vanson2209/final_project/Circuit/Receive_station_pdf.pdf

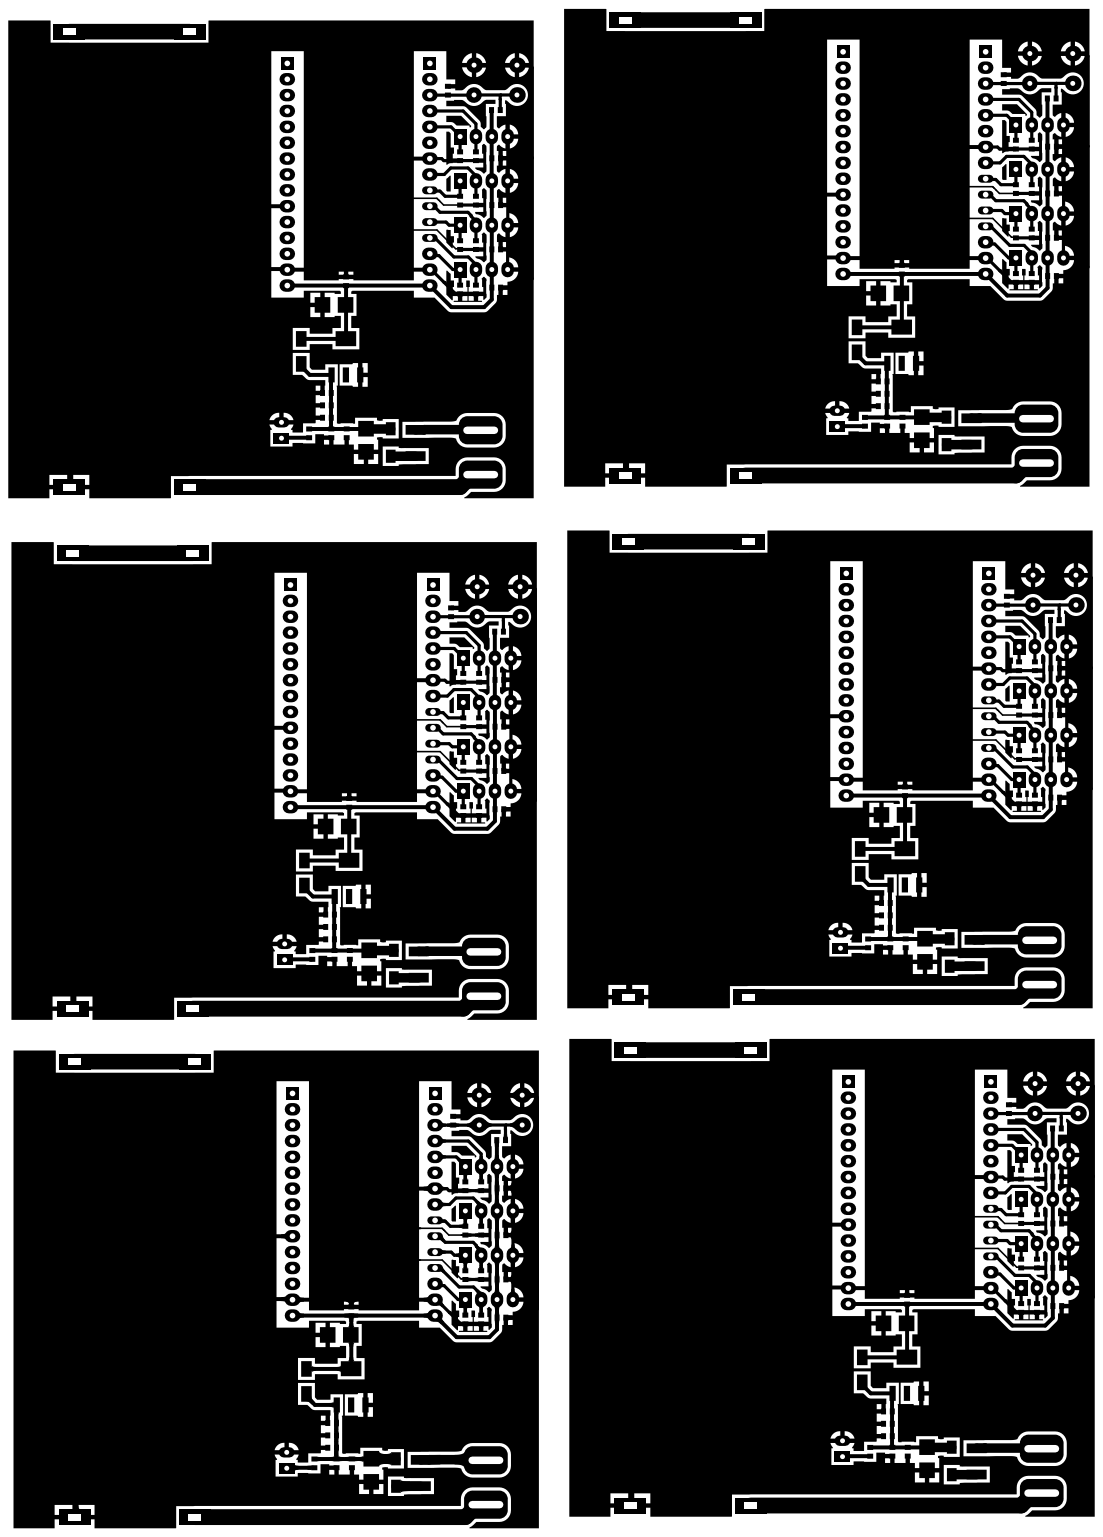
[picture p213: page 1]
