vanson2209/final_project/Circuit/PIN_3/PIN_3.pdf

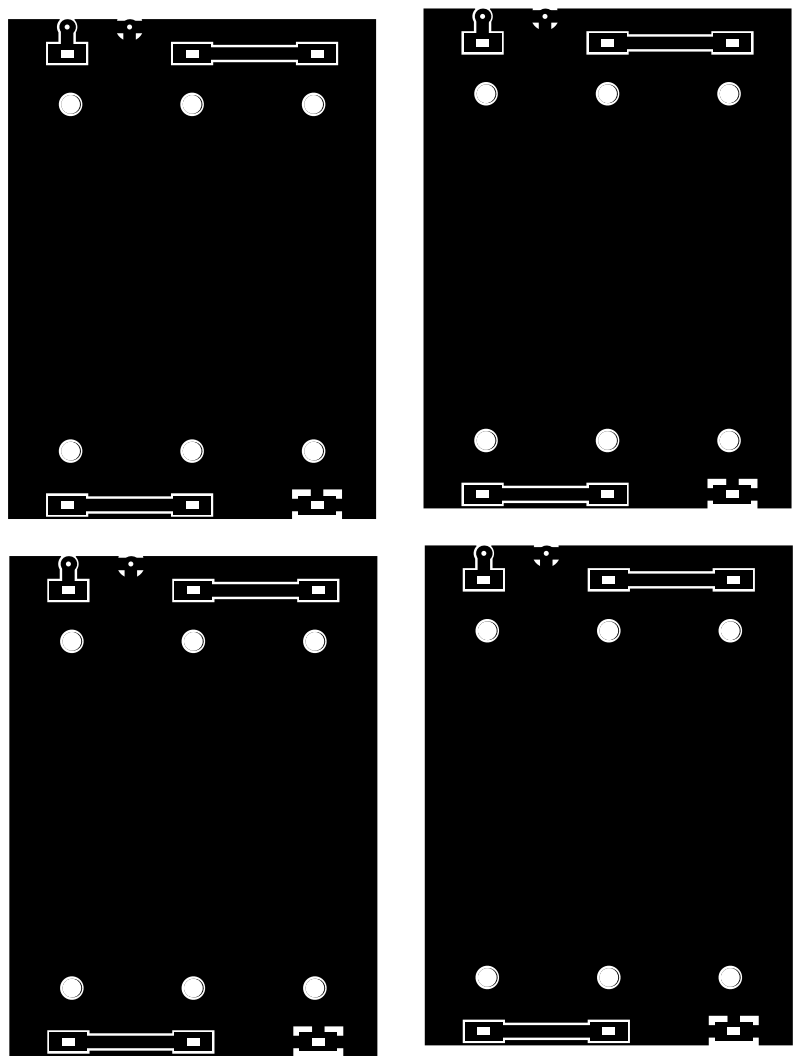
[picture p214: page 1]
