vanson2209/final_project/Circuit/Remote/Remote_BOTTOM.pdf

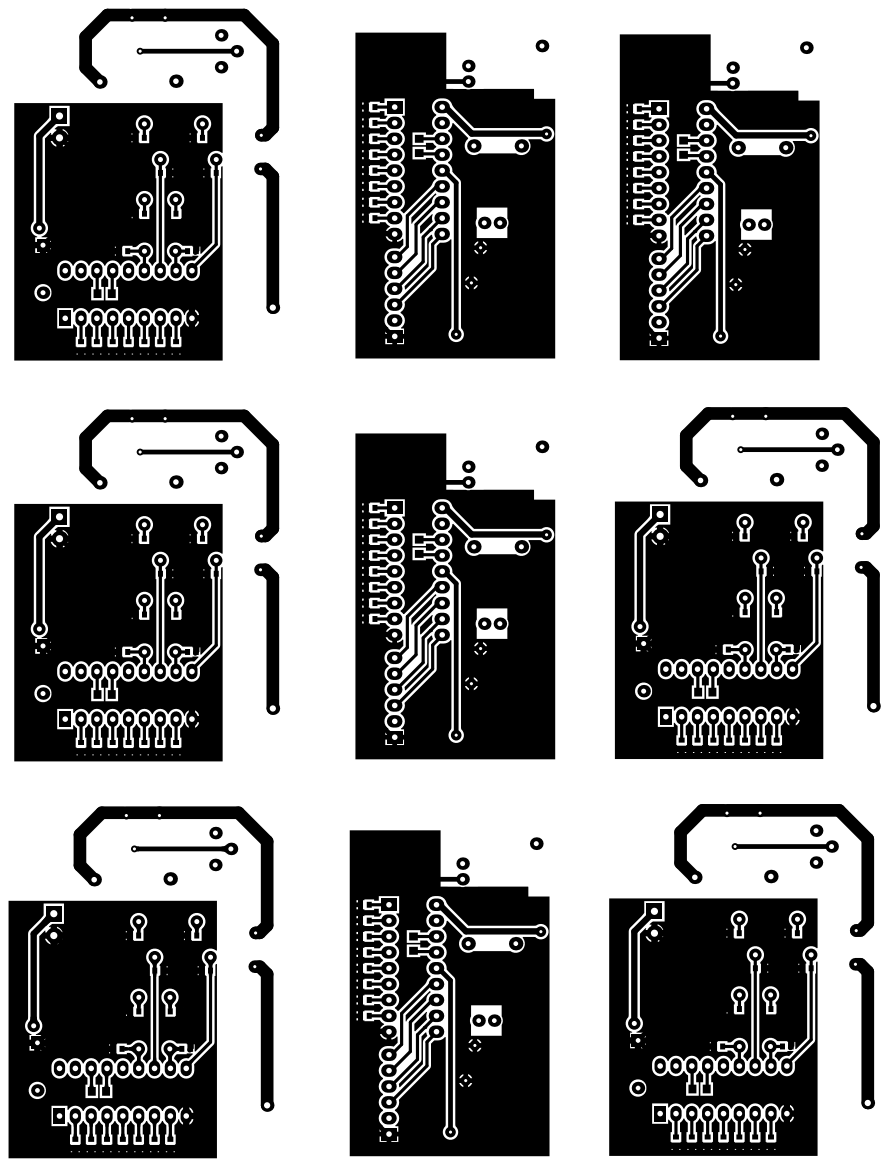
[picture p215: page 1]
