vanson2209/final_project/Circuit/Remote/Remote_TOP.pdf

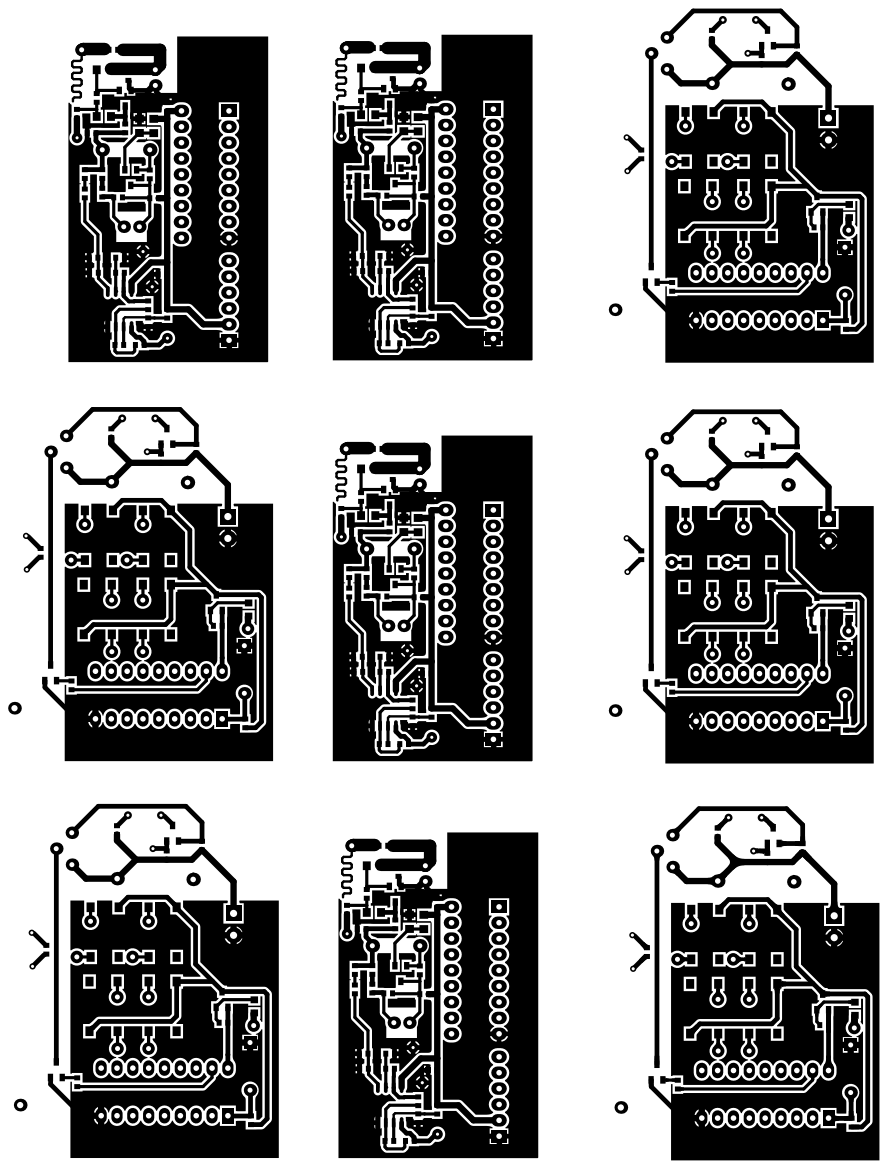
[picture p216: page 1]
