vanson2209/final_project/Circuit/Remote/Remote_V3.pdf

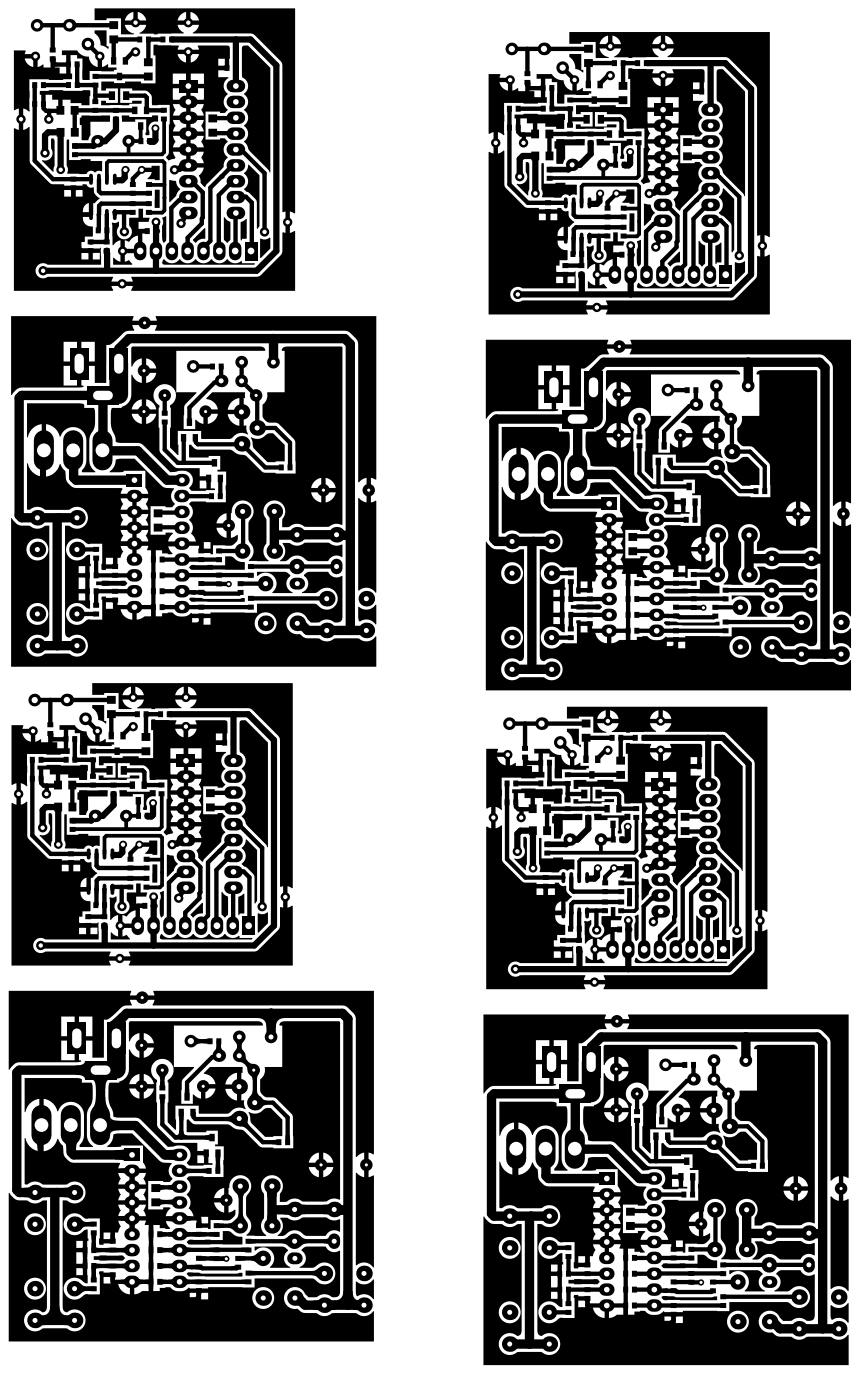
[picture p217: page 1]
