vanson2209/final_project/Circuit/Remote/Transfer/Transfer_V3.pdf

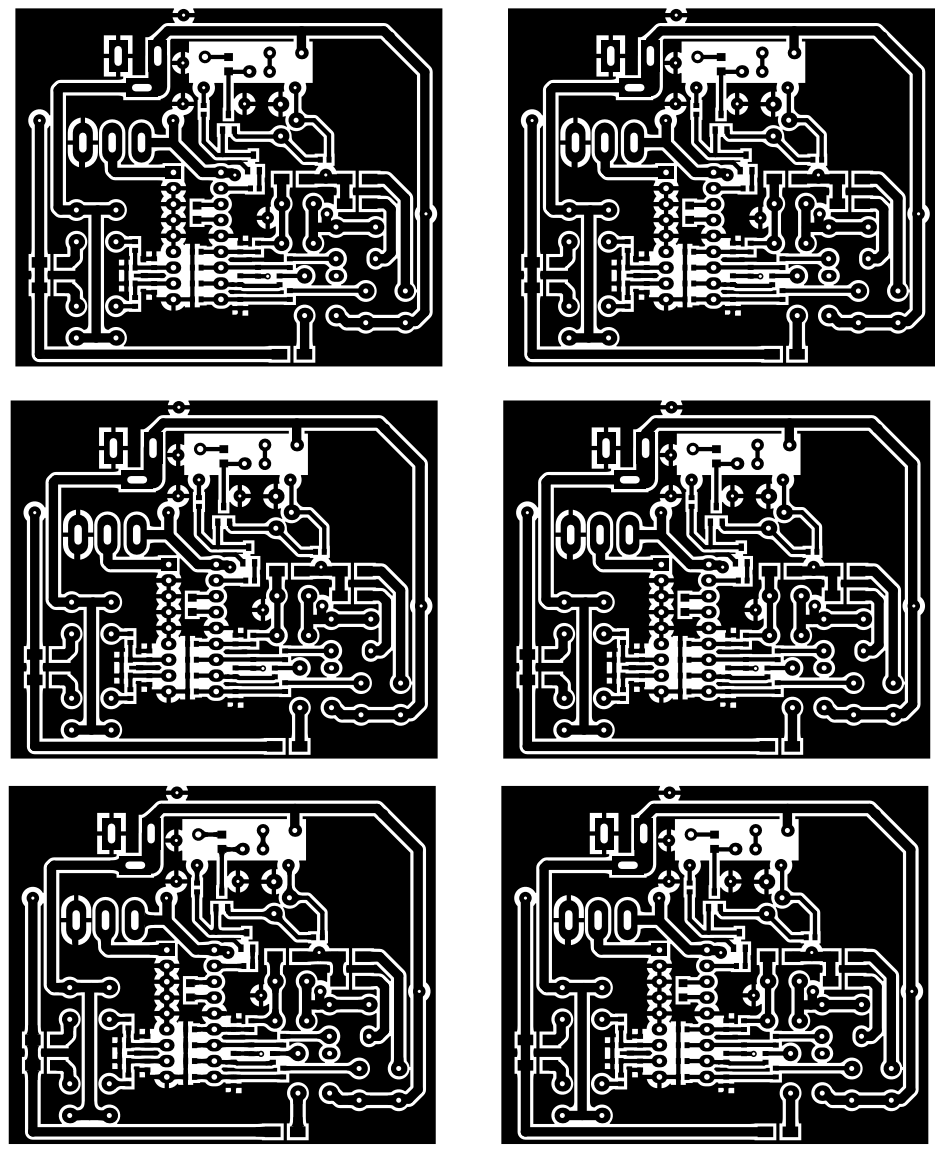
[picture p218: page 1]
