vanson2209/final_project/Circuit/Remote/Remote_V2.pdf

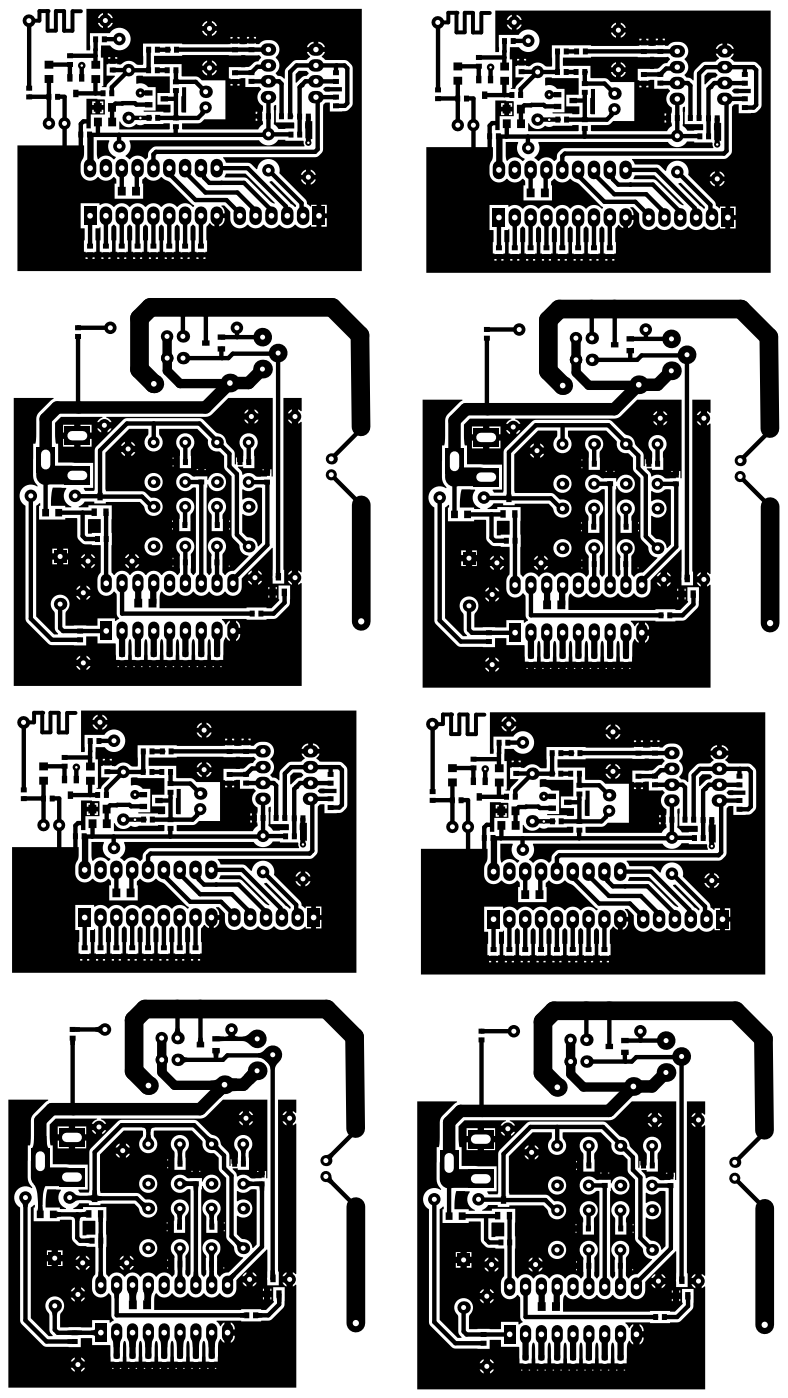
[picture p219: page 1]
