vanson2209/final_project/(list of files, drawings)

Other design files:
Circuit/Hall_Sensor_SMD/IO_AGV.PrjPcb
Circuit/Hall_Sensor_SMD/IO_Hall_Sensor_SMD_Pcb.PcbDoc
Circuit/Hall_Sensor_SMD/IO_Hall_Sensor_SMD_Sch.SchDoc
Circuit/Main_V1/Control.SchDoc
Circuit/Main_V1/Main_V1.PrjPcb
Circuit/Main_V1/Peripheral.SchDoc
Circuit/Main_V1/Power.SchDoc
Circuit/PIN_3/PIN_3.PrjPcb
Circuit/PIN_3/PIN_3_Pcb.PcbDoc
Circuit/PIN_3/PIN_3_Sch.SchDoc
Circuit/PIN_12V/PIN_12V.PrjPcb
Circuit/PIN_12V/PIN_12V_Pcb.PcbDoc
Circuit/PIN_12V/PIN_12V_Sch.SchDoc
Circuit/Receive_Station/Receive_Station.PrjPcb
Circuit/Receive_Station/Receive_Station_PCB.PcbDoc
Circuit/Receive_Station/Receive_Station_Sch.SchDoc
Circuit/Remote/Receive/Receive_V1.PrjPcb
Circuit/Remote/Receive/Receive_V1_Pcb.PcbDoc
Circuit/Remote/Receive/Receive_V1_Sch.SchDoc
Circuit/Remote/Receive_V1.PrjPcb
Circuit/Remote/Receive_V1_Pcb.PcbDoc
Circuit/Remote/Receive_V1_Sch.SchDoc
Circuit/Remote/Transfer/Transfer/Transfer.PrjPcb
Circuit/Remote/Transfer/Transfer/Transfer_V1_Sch.SchDoc
Circuit/Remote_Circuit/Remote_Circuit.PrjPcb
Circuit/Remote_Circuit/Remote_Circuit_Pcb.PcbDoc
Circuit/Remote_Circuit/Remote_Circuit_Sch.SchDoc
Circuit/signal_circuit/PCB1.PcbDoc
Circuit/signal_circuit/signal_circuit.PrjPcb
Circuit/signal_circuit/signal_circuit_PCB.PcbDoc
Circuit/signal_circuit/signal_circuit_Sch.SchDoc
Circuit/signal_transfer/signal_transfer.PrjPcb
Circuit/signal_transfer/signal_transfer_Pcb.PcbDoc
Circuit/signal_transfer/signal_transfer_Sch.SchDoc
Circuit/Slave_Board/Slave_Board.PrjPcb
Circuit/Slave_Board/Slave_Board_Sch.SchDoc
Simulate/Remote.ms14
