vanson2209/final_project/Code/AGV/Core/Src/main.c

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
/* Includes ------------------------------------------------------------------*/
#include "main.h"

/* USER CODE BEGIN Includes */
#include "math.h"
#include "lcd.h"
/* USER CODE END Includes */

/* USER CODE BEGIN PTD */
typedef enum {AUTO = 0, NONE_AUTO_REMOTE, NONE_AUTO_WEB, STOP} state_t;
typedef enum {MOVE = 0, PROCESS} state_moving_t;
typedef enum {PASS_START = 0, LEFT_START} state_start_t;
typedef enum {START = 0, PICK_UP, SHIP, COME_BACK, COME_HOME} state_process_t;
typedef enum {PRE_UP = 0, WAIT_UP, OPERATE, WAIT_DONE_PICK, DONE_PICK} state_pick_t;
typedef enum {PROCESS_SHIP = 0, GO_SHIP, PUT_DOWN, DONE_SHIP} state_ship_t;
typedef enum {PROCESS_GO = 0, WAIT_CROSS} state_go_t;
typedef enum {PRE_DOWN = 0, WAIT_ROBOT, PROCESS_PUT_DOWN, DONE_PUT_DOWN} state_put_down_t;
typedef enum {PRE_CB = 0, GO_CB, DONE_CB} state_comeback_t;
typedef enum {PRE_CH = 0, GO_HOME, LEFT_CH, WAIT_DONE_CH, DONE_CH} state_come_home_t;
typedef enum {PRE_STOP = 0, CHECK_OUT, WAIT_OUT} state_stop_t;

typedef enum {CHECK_SIGN_LEFT = 0, PASS_LEFT_1, TURN_LEFT, PASS_LEFT_2} state_turn_left_intersection_t;
typedef enum {CHECK_SIGN_RIGHT = 0, TURN_RIGHT} state_turn_right_intersection_t;
typedef enum {CHECK_SIGN_CROSS = 0, PASS_CROSS_1, PASS_CROSS_2} state_cross_intersection_t;
typedef enum {CHECK_SIGN_BACK = 0, PASS_BACK_1, TURN_LEFT_1, TURN_LEFT_2, PASS_BACK_2} state_back_intersection_t;

typedef enum {PS1 = 0, TS1, RS1, RS2, PS2, TS2, RS3, RS4} list_station_t;
typedef enum {UP = 0, DOWN, LEFT, RIGHT, PAUSE} direct_t;

typedef enum {reset = 0, set} bool_t;

typedef struct{
	uint8_t goods_position[4];
	uint8_t goods_quantity;
	uint8_t goods_tmp;
	list_station_t goods_list[4];
	bool_t goods_side[4];
	bool_t goods_station[2];
} goods_infor_t;

typedef struct{
	uint8_t agv_position;
	uint8_t agv_side;
	direct_t agv_direct;
	direct_t agv_next_step_go;
	volatile bool_t agv_power;
} AGV_infor_t;

/* USER CODE END PTD */

/* USER CODE BEGIN PD */
#define line_sensor 	35
#define i_axis				5
#define j_axis				5
#define GPIO_SET_PIN(GPIOx, GPIO_Pin_x) (GPIOx -> ODR |= GPIO_Pin_x)
#define GPIO_RESET_PIN(GPIOx, GPIO_Pin_x) (GPIOx -> ODR &= ~GPIO_Pin_x)

/* USER CODE END PD */

ADC_HandleTypeDef hadc1;
DMA_HandleTypeDef hdma_adc1;

I2C_HandleTypeDef hi2c2;

TIM_HandleTypeDef htim2;

UART_HandleTypeDef huart1;

/* USER CODE BEGIN PV */
uint16_t distance_tmp;
volatile uint32_t systick_count;
volatile state_t state;
state_moving_t state_moving;
state_stop_t state_stop;
state_process_t process_state;
state_pick_t pick_state;
state_ship_t ship_state;
state_go_t state_go;
state_put_down_t state_put_down;
state_start_t start;
state_comeback_t state_comeback;
volatile state_come_home_t state_come_home;

state_cross_intersection_t cross_interection_state = CHECK_SIGN_CROSS;
state_turn_left_intersection_t turn_left_interection_state = CHECK_SIGN_LEFT;
state_turn_right_intersection_t turn_right_interection_state = CHECK_SIGN_RIGHT;
state_back_intersection_t state_back_intersection = CHECK_SIGN_BACK;

volatile bool_t robot;

goods_infor_t goods_infor;
AGV_infor_t	agv_infor;

uint8_t Rx;
uint8_t Tx;
direct_t direct;

uint16_t data[5], data_max[5], data_min[5]; // gia tri mau tu
uint16_t sensor[5]; // gia tri doc mau tu
uint8_t check[5];	// gia tri kiem tra mau tu


uint8_t tmp_check;

/* USER CODE END PV */

void SystemClock_Config(void);
static void MX_GPIO_Init(void);
static void MX_DMA_Init(void);
static void MX_ADC1_Init(void);
static void MX_TIM2_Init(void);
static void MX_I2C2_Init(void);
static void MX_USART1_UART_Init(void);
/* USER CODE BEGIN PFP */

void V_Go_Straight(void);
void V_Go_Back(void);
void V_Turn_Left(void);
void V_Turn_Right(void);
void V_Control_Remote(void);
void V_Control_Web(void);

uint8_t V_Check_Sensor_Init(void);
void V_Sensor_Init(void);
uint8_t V_Check_Sensor(void);

void V_Start(void);
void V_Pick_Up(void);
void V_Ship(void);
void V_Come_Back(void);
void V_Come_Home(void);



void V_Put_Down(void);
 
void V_Analysis_Goods_List(bool_t v_goods_side[4], uint8_t v_goods_position[4], list_station_t v_goods_list[4]);

void V_Cross_the_Intersection(void);
void V_Turn_Left_at_the_Intersection(void);
void V_Turn_Right_at_the_Intersection(void);
void V_Turn_Back_at_the_Intersection(void);

void V_Determine_Next_Step(void);
uint16_t V_Determine_Distance(uint8_t xo, uint8_t yo, uint8_t x1, uint8_t y1, direct_t v_direct);
void V_Remove_Duplicate(list_station_t v_goods_list[4],  uint8_t* goods_quantity);
void V_Remove_First_Goods(list_station_t v_goods_list[4],  uint8_t goods_quantity);
void V_GO(void);

/* USER CODE END PFP */

/**
  * @brief  The application entry point.
  * @retval int
  */
int main(void)
{
  /* MCU Configuration--------------------------------------------------------*/

  /* Reset of all peripherals, Initializes the Flash interface and the Systick. */
  HAL_Init();

  /* Configure the system clock */
  SystemClock_Config();

  /* Initialize all configured peripherals */
  MX_GPIO_Init();
  MX_DMA_Init();
  MX_ADC1_Init();
  MX_TIM2_Init();
  MX_I2C2_Init();
  MX_USART1_UART_Init();
  /* USER CODE BEGIN 2 */
	state = AUTO;
	state_moving = MOVE;
	state_stop = PRE_STOP;
	process_state = START;
	pick_state = PRE_UP;
	ship_state = PROCESS_SHIP;
	state_go = PROCESS_GO;
	state_put_down = PRE_DOWN;
	start = PASS_START;
	robot = set;
	agv_infor.agv_power = reset;
	state_comeback = PRE_CB;
	state_come_home = PRE_CH;
	goods_infor.goods_station[0] = set;
	goods_infor.goods_station[1] = set;

	cross_interection_state = CHECK_SIGN_CROSS;
	turn_left_interection_state = CHECK_SIGN_LEFT;
	turn_right_interection_state = CHECK_SIGN_RIGHT;
	V_Go_Straight();
	HAL_TIM_PWM_Start(&htim2, TIM_CHANNEL_1);
	HAL_TIM_PWM_Start(&htim2, TIM_CHANNEL_2);
	Lcd_Init();
	
	HAL_UART_Receive_IT(&huart1, &Rx, 1);
	Tx = '0';
	HAL_UART_Transmit(&huart1, &Tx, 1, 100);
	while(agv_infor.agv_power != set){}
	Tx = '1';
	HAL_UART_Transmit(&huart1, &Tx, 1, 100);
	do
	{
		Lcd_Send_String_XY(1, 4, "Sampling!");
		Lcd_Goto_XY(2,1);
		Lcd_Send_String("Wait, Please!");
		V_Sensor_Init();
	}
	while(V_Check_Sensor_Init());
	htim2.Instance -> CCR1 = 8771;
	htim2.Instance -> CCR2 = 8888;
	Tx = '2';
	HAL_UART_Transmit(&huart1, &Tx, 1, 100);
	Lcd_Send_String_XY(1, 3, "GOING TO TS1");
	HAL_Delay(500);
  /* USER CODE END 2 */

  /* Infinite loop */
  /* USER CODE BEGIN WHILE */
  while (1)
  {
    /* USER CODE END WHILE */

    /* USER CODE BEGIN 3 */
		switch(state)
		{
			case AUTO:
			{	
				switch(state_moving)
				{
					case MOVE:
					{
						HAL_ADC_Start_DMA(&hadc1, (uint32_t *)data, 5);
						HAL_Delay(1);
						HAL_ADC_Stop_DMA(&hadc1);
						switch(V_Check_Sensor())
						{
							case 0:
								htim2.Instance -> CCR1 = 9868;	//AGV1			//AGV1: val1:val2 = 9868:9999
								htim2.Instance -> CCR2 = 9999;
								break;
							case 1:
								htim2.Instance -> CCR1 = 9868;	//AGV2
								htim2.Instance -> CCR2 = 8888;
								break;
							case 2:
								htim2.Instance -> CCR1 = 9868;	//AGV2
								htim2.Instance -> CCR2 = 5555;
								break;
							case 3:
								htim2.Instance -> CCR1 = 9868;	//AGV2
								htim2.Instance -> CCR2 = 3333;
								break;
							case 4:
								htim2.Instance -> CCR1 = 9868;	//AGV2
								htim2.Instance -> CCR2 = 1666;
								break;
							case 5:
								htim2.Instance -> CCR1 = 8771;	//AGV2
								htim2.Instance -> CCR2 = 9999;
								break;
							case 6:
								htim2.Instance -> CCR1 = 5482;	//AGV2
								htim2.Instance -> CCR2 = 9999;
								break;
							case 7:
								htim2.Instance -> CCR1 = 3289;	//AGV2
								htim2.Instance -> CCR2 = 9999;
								break;
							case 8:
								htim2.Instance -> CCR1 = 1644;	//AGV2
								htim2.Instance -> CCR2 = 9999;
								break;
							case 9:
								state_moving = PROCESS;
								break;
						}
						break;
					}
					case PROCESS:
					{
						switch (process_state)
						{
							case START:
								V_Start();
								break;
							case PICK_UP:
								V_Pick_Up();
								break;
							case SHIP:
								V_Ship();
									break;
							case COME_BACK:
								V_Come_Back();
								break;
							case COME_HOME:
								V_Come_Home();
						}
						break;
					}
				}
				break;
			}
			case NONE_AUTO_REMOTE:
				V_Control_Remote();
				break;
			case NONE_AUTO_WEB:
				V_Control_Web();
				break;
			case STOP:
			{
				switch(state_stop)
				{
					case PRE_STOP:
						htim2.Instance -> CCR1 = 0;
						htim2.Instance -> CCR2 = 0;
						systick_count = HAL_GetTick();
						state_stop = CHECK_OUT;
						break;
					case CHECK_OUT:
						if((GPIOB -> IDR  & GPIO_PIN_2) == GPIO_PIN_RESET)
						{
							if((HAL_GetTick() - systick_count) < 50)
							{
								state_stop = PRE_STOP;
								state = AUTO;
							}
							else
							{
								systick_count = HAL_GetTick();
								state_stop = WAIT_OUT;
							}
						}
						break;
					case 	WAIT_OUT:
						if((HAL_GetTick() - systick_count) > 1000)
						{
							state_stop = PRE_STOP;
							state = AUTO;
						}
						break;
				}
				break;
			}
		}
		
  }
  /* USER CODE END 3 */
}

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
/* USER CODE BEGIN 4 */

void HAL_GPIO_EXTI_Callback(uint16_t GPIO_Pin)
{
	switch (GPIO_Pin)
	{
		case GPIO_PIN_7:
			if(state == AUTO)
			{
				state = NONE_AUTO_REMOTE;
				htim2.Instance -> CCR1 = 0;
				htim2.Instance -> CCR2 = 0;
			}
			else
				state = AUTO;
			break;
		case GPIO_PIN_2:
				state = STOP;
			break;
	}
}
void HAL_UART_RxCpltCallback(UART_HandleTypeDef *huart)
{	
	HAL_UART_Receive_IT(&huart1, &Rx, 1);
	switch (Rx)
	{
		case '0':
			agv_infor.agv_power = set;	//POWER_ON
			Tx = 'E';
			HAL_UART_Transmit(&huart1, &Tx, 1, 100);
			break;
		case '1':
			agv_infor.agv_power = reset;	//POWER_OFF
			Tx = 'F';
			HAL_UART_Transmit(&huart1, &Tx, 1, 100);
			break;
		case '2':		//off the automation
			htim2.Instance -> CCR1 = 0;
			htim2.Instance -> CCR2 = 0;
			state = NONE_AUTO_WEB;
			break;
		case '3':			//on the automation
			state = AUTO;
			break;
		case '4':
			robot = reset;
			break;
		case '5':
			goods_infor.goods_list[goods_infor.goods_quantity] = RS1;
			goods_infor.goods_quantity ++;
			break;
		case '6':
			goods_infor.goods_list[goods_infor.goods_quantity] = RS2;
			goods_infor.goods_quantity ++;
			break;
		case '7':
			goods_infor.goods_list[goods_infor.goods_quantity] = RS3;
			goods_infor.goods_quantity ++;
			break;
		case '8':
			goods_infor.goods_list[goods_infor.goods_quantity] = RS4;
			goods_infor.goods_quantity ++;
			break;
		case '9':
			direct = UP;
			break;
		case 'A':
			direct = DOWN;
			break;
		case 'B':
			direct = LEFT;
			break;
		case 'C':
			direct = RIGHT;
			break;
		case 'D':
			direct = PAUSE;
			break;
		case 'E':
			goods_infor.goods_station[0] = reset;
			if((process_state == PICK_UP) && (goods_infor.goods_quantity == 0))
				pick_state = PRE_UP;
			break;
		case 'F':
			goods_infor.goods_station[1] = reset;
			if((process_state == PICK_UP) && (goods_infor.goods_quantity == 0))
				pick_state = PRE_UP;
			break;
		case 'G':
			goods_infor.goods_station[0] = set;
			break;
		case 'H':
			goods_infor.goods_station[1] = set;
			break;
	}
}
void V_Go_Straight(void)
{
	GPIO_RESET_PIN(GPIOA, GPIO_PIN_10);	//STB`
	GPIO_SET_PIN(GPIOA, GPIO_PIN_11);   //AIN1
	GPIO_RESET_PIN(GPIOA, GPIO_PIN_12);	//AIN2
	GPIO_SET_PIN(GPIOB, GPIO_PIN_4);   //BIN2
	GPIO_RESET_PIN(GPIOB, GPIO_PIN_5);	//BIN1
	GPIO_SET_PIN(GPIOA, GPIO_PIN_10);	//STB`
}
void V_Go_Back(void)
{
	GPIO_RESET_PIN(GPIOA, GPIO_PIN_10);	//STB`
	GPIO_RESET_PIN(GPIOA, GPIO_PIN_11);   //AIN1
	GPIO_SET_PIN(GPIOA, GPIO_PIN_12);	//AIN2
	GPIO_RESET_PIN(GPIOB, GPIO_PIN_4);   //BIN2
	GPIO_SET_PIN(GPIOB, GPIO_PIN_5);	//BIN1
	GPIO_SET_PIN(GPIOA, GPIO_PIN_10);	//STB`
}
void V_Turn_Left(void)
{
	htim2.Instance -> CCR1 = 8771;
	htim2.Instance -> CCR2 = 8888;
	HAL_Delay(600);
	GPIO_RESET_PIN(GPIOA, GPIO_PIN_10);	//STB`
	GPIO_RESET_PIN(GPIOA, GPIO_PIN_11);   //AIN1
	GPIO_SET_PIN(GPIOA, GPIO_PIN_12);	//AIN2
	GPIO_SET_PIN(GPIOA, GPIO_PIN_10);	//STB
	HAL_Delay(500);
	systick_count = HAL_GetTick();
	do
	{
		HAL_ADC_Start_DMA(&hadc1, (uint32_t *)data, 5);
		HAL_Delay(1);
		HAL_ADC_Stop_DMA(&hadc1);
		tmp_check = V_Check_Sensor();
	//	if((tmp > 4) && (tmp < 8))
		if((tmp_check == 0) || (tmp_check == 1) || (tmp_check == 5))
				break;
	} while((HAL_GetTick() - systick_count) < 500);
	GPIO_RESET_PIN(GPIOA, GPIO_PIN_10);	//STB`
	GPIO_SET_PIN(GPIOA, GPIO_PIN_11);   //AIN1
	GPIO_RESET_PIN(GPIOA, GPIO_PIN_12);	//AIN2
	GPIO_SET_PIN(GPIOA, GPIO_PIN_10);	//STB`
}
void V_Turn_Right(void)
{
	htim2.Instance -> CCR1 = 8771;
	htim2.Instance -> CCR2 = 8888;
	HAL_Delay(600);
	GPIO_RESET_PIN(GPIOA, GPIO_PIN_10);	//STB`
	GPIO_RESET_PIN(GPIOB, GPIO_PIN_4);   //BIN2
	GPIO_SET_PIN(GPIOB, GPIO_PIN_5);	//BIN1
	GPIO_SET_PIN(GPIOA, GPIO_PIN_10);	//STB`
	HAL_Delay(500);
	systick_count = HAL_GetTick();
	do
	{
		HAL_ADC_Start_DMA(&hadc1, (uint32_t *)data, 5);
		HAL_Delay(1);
		HAL_ADC_Stop_DMA(&hadc1);
		tmp_check = V_Check_Sensor();
		if((tmp_check == 0) || (tmp_check == 1) || (tmp_check == 5))
				break;
	} while((HAL_GetTick() - systick_count) < 500);
	GPIO_RESET_PIN(GPIOA, GPIO_PIN_10);	//STB`
	GPIO_SET_PIN(GPIOB, GPIO_PIN_4);   //BIN1
	GPIO_RESET_PIN(GPIOB, GPIO_PIN_5);	//BIN2
	GPIO_SET_PIN(GPIOA, GPIO_PIN_10);	//STB
}
void V_Control_Remote(void)
{
	if((GPIOB->IDR & GPIO_PIN_1) != GPIO_PIN_RESET)		//UP
	{
		if((GPIOA->IDR & GPIO_PIN_12) != GPIO_PIN_RESET)
			V_Go_Straight();
		htim2.Instance -> CCR1 = 9900;
		htim2.Instance -> CCR2 = 9999;
	}
	else if((GPIOA->IDR & GPIO_PIN_5) != GPIO_PIN_RESET)	//DOWN
	{
		if((GPIOA->IDR & GPIO_PIN_11) != GPIO_PIN_RESET)
			V_Go_Back();
		htim2.Instance -> CCR1 = 9900;
		htim2.Instance -> CCR2 = 9999;
	}
	else if((GPIOB->IDR & GPIO_PIN_0) != GPIO_PIN_RESET)	//LEFT
	{
		htim2.Instance -> CCR1 = 2192;
		htim2.Instance -> CCR2 = 9999;
	}
	else if((GPIOA->IDR & GPIO_PIN_6) != GPIO_PIN_RESET)		//RIGHT
	{
		htim2.Instance -> CCR1 = 9868;
		htim2.Instance -> CCR2 = 2222;
	}
	else
	{
		htim2.Instance -> CCR1 = 0;
		htim2.Instance -> CCR2 = 0;
	}
}
void V_Control_Web(void)
{
	if(direct == UP)		//UP
	{
		htim2.Instance -> CCR1 = 7675;
		htim2.Instance -> CCR2 = 7777;
	}
	else if(direct == DOWN)	//DOWN
	{
		V_Go_Back();
	}
	else if(direct == LEFT)	//LEFT
	{
		htim2.Instance -> CCR1 = 2192;
		htim2.Instance -> CCR2 = 7777;
	}
	else if(direct == RIGHT)		//RIGHT
	{
		htim2.Instance -> CCR1 = 7675;
		htim2.Instance -> CCR2 = 2222;
	}
	else if(direct == PAUSE)		//RIGHT
	{
		htim2.Instance -> CCR1 = 0;
		htim2.Instance -> CCR2 = 0;
	}
}
uint8_t V_Check_Sensor_Init(void) 
{
	uint8_t i, k = 0;
	for(i = 0; i < 5; i++)
	{
		if(((data_max[i] - data_min[i]) > 15) || ((sensor[i] - data[i]) > 10) || ((data[i] -sensor[i]) > 10))
			k++;
		else check[i] = 1;
	}
	if(k == 0) return 0;
	else return 1;
}
void V_Sensor_Init(void)
{
	uint8_t i;
	for( i = 0; i < 5; i++) 
	{
		if(check[i] == 0)
		{
			data_max[i] = 0;
			data_min[i] = ~0;
		}
	}
	systick_count = HAL_GetTick();
	while((HAL_GetTick() - systick_count) < 5000) 
	{
		HAL_ADC_Start_DMA(&hadc1, (uint32_t *)data, 5);
		HAL_Delay(1);
		HAL_ADC_Stop_DMA(&hadc1);
		if((HAL_GetTick() - systick_count) > 1000)
		{
			for(i = 0; i < 5; i++) 
			{
				if((check[i] == 0) && ((data[i] - data_min[i]) < 10) && ((data_max[i] - data[i]) < 10))
				{
					if(data[i] > data_max[i]) data_max[i] = data[i];
					if(data[i] < data_min[i]) data_min[i] = data[i];
				}
			}
		}
	}
	for(i = 0; i < 5; i++) sensor[i] = (55*data_max[i] + 45*data_min[i])/100; 
}
uint8_t V_Check_Sensor(void)
{
	if ((data[0] > sensor[0] + line_sensor) && (data[1] > sensor[1] + line_sensor) && (data[2] > sensor[2] + line_sensor) && (data[3] > sensor[3] + line_sensor) && (data[4] > sensor[4] + line_sensor))
		return 9;
	else if ((data[0] > sensor[0] + line_sensor) && (data[1] > sensor[1] + line_sensor) && (data[2] > sensor[2] + line_sensor) && (data[3] > sensor[3] + line_sensor))
		return 9;
	else if ((data[4] > sensor[4] + line_sensor) && (data[1] > sensor[1] + line_sensor) && (data[2] > sensor[2] + line_sensor) && (data[3] > sensor[3] + line_sensor))
		return 9;
	else if ((data[1] > sensor[1] + line_sensor) && (data[2] > sensor[2] + line_sensor) && (data[3] > sensor[3] + line_sensor))
		return 0;
	else if ((data[0] > sensor[0] + line_sensor) && (data[1] > sensor[1] + line_sensor) && (data[2] > sensor[2] + line_sensor))
		return 2;
	else if ((data[2] > sensor[2] + line_sensor) && (data[3] > sensor[3] + line_sensor) && (data[4] > sensor[4] + line_sensor))
		return 6;
	else if ((data[1] > sensor[1] + line_sensor) && (data[2] > sensor[2] + line_sensor))
		return 1;
	else if ((data[0] > sensor[0] + line_sensor) && (data[1] > sensor[1] + line_sensor))
		return 3;
	else if ((data[2] > sensor[2] + line_sensor) && (data[3] > sensor[3] + line_sensor))
		return 5;
	else if ((data[3] > sensor[3] + line_sensor) && (data[4] > sensor[4] + line_sensor))
		return 7;
	else if (data[0] > sensor[0] + line_sensor)
		return 4;
	else if (data[4] > sensor[4] + line_sensor)
		return 8;
	//else return 1;
}

void V_Start(void)
{
	switch(start)
	{
		case PASS_START:
			htim2.Instance -> CCR1 = 9868;
			htim2.Instance -> CCR2 = 9999;
			HAL_Delay(300);
			start = LEFT_START;
			break;
		case LEFT_START:
			V_Turn_Left();
			agv_infor.agv_side = 0;
			agv_infor.agv_position = 0;
			goods_infor.goods_list[0] = TS1;
			agv_infor.agv_direct = UP;
			process_state = COME_BACK;
			start = PASS_START;
			break;
	}
	state_moving = MOVE;
}

void V_Pick_Up(void)
{
	switch(pick_state)
	{	
		case PRE_UP:
			if((goods_infor.goods_station[0] == reset) && (goods_infor.goods_station[1] == reset))
			{
				process_state = COME_HOME;
				goods_infor.goods_list[0] = PS1;
			}
			else
			{
				if(agv_infor.agv_direct == RIGHT)
				{
					if(agv_infor.agv_side == 1)
					{
						if(goods_infor.goods_station[0] == reset)
						{
							process_state = COME_BACK;
							goods_infor.goods_list[0] = TS2;
						}
						else
						{
							pick_state = WAIT_UP;
						}
					}
					else
					{
						if(goods_infor.goods_station[1] == reset)
						{
							process_state = COME_BACK;
							goods_infor.goods_list[0] = TS1;
						}
						else
						{
							pick_state = WAIT_UP;
						}
					}
				}
				else
				{
					if(agv_infor.agv_side == 0)
					{
						if(goods_infor.goods_station[0] == reset)
						{
							process_state = COME_BACK;
							goods_infor.goods_list[0] = TS2;
						}
						else
						{
							pick_state = WAIT_UP;
						}
					}
					else
					{
						if(goods_infor.goods_station[1] == reset)
						{
							process_state = COME_BACK;
							goods_infor.goods_list[0] = TS1;
						}
						else
						{
							pick_state = WAIT_UP;
						}
					}
				}
			}
			break;
		case WAIT_UP:
			htim2.Instance -> CCR1 = 0;
			htim2.Instance -> CCR2 = 0;
			Lcd_Send_String_XY(1, 4, "PICKING!");
			Lcd_Goto_XY(2, 0);
			if(agv_infor.agv_direct == LEFT)
			{
				if(agv_infor.agv_side == 0)
					Tx = '3';
				else 
					Tx = '4';
			}
			else
			{
				if(agv_infor.agv_side == 1)
					Tx = '3';
				else 
					Tx = '4';
			}
			HAL_UART_Transmit(&huart1, &Tx, 1, 100);
			pick_state = OPERATE;
			break;
		case	OPERATE:
		{
			if(robot == reset)
			{
				goods_infor.goods_tmp = 0;
				V_Remove_Duplicate(goods_infor.goods_list, &goods_infor.goods_quantity);
				V_Analysis_Goods_List(goods_infor.goods_side, goods_infor.goods_position, goods_infor.goods_list);
				pick_state = WAIT_DONE_PICK;
			}
			else
			{
				if(goods_infor.goods_quantity > goods_infor.goods_tmp)
				{ 
					switch (goods_infor.goods_list[goods_infor.goods_tmp])
					{
						case RS1:
							Lcd_Send_String("-RS1");
							break;
						case RS2:
							Lcd_Send_String("-RS2");
							break;
						case RS3:
							Lcd_Send_String("-RS3");
							break;
						case RS4:
							Lcd_Send_String("-RS4");
							break;
						default:
							break;
					}
					goods_infor.goods_tmp = goods_infor.goods_quantity;
				}
			}
			break;
		}
		case WAIT_DONE_PICK:	//finish receiving
//			Lcd_Send_String_XY(1, 0, "FINISH RECEIVING");
//			systick_count = HAL_GetTick();
			pick_state = DONE_PICK;
			robot = set;
			break;
		case DONE_PICK:
//			if((HAL_GetTick() - systick_count) > 1500)
			{
				Lcd_Clear_Display();
				pick_state = PRE_UP;
				process_state = SHIP;
			}
			break;
	}
}

void V_Analysis_Goods_List(bool_t v_goods_side[4], uint8_t v_goods_position[4], list_station_t v_goods_list[4])
{
	for(uint8_t x = 0; x < goods_infor.goods_quantity; x++)
	{
		v_goods_position[x] = v_goods_list[x] & 3;
		v_goods_side[x] = 	(bool_t)((v_goods_list[x] & 4) >> 2);
	}
}

uint16_t V_Determine_Distance(uint8_t xo, uint8_t yo, uint8_t x1, uint8_t y1, direct_t v_direct)
{
	uint16_t result;
	if(v_direct == LEFT)
		result = pow((int16_t)((xo*i_axis + 9) - x1*i_axis), 2) + pow((int16_t)((yo*j_axis + 2) - y1*j_axis), 2);
	else
		result = pow((int16_t)(((xo - 1)*i_axis - 1) - x1*i_axis), 2) + pow((int16_t)((yo*j_axis + 7) - y1*j_axis), 2);
	return result;
}
void V_Remove_Duplicate(list_station_t v_goods_list[4],  uint8_t* goods_quantity)
{
	uint8_t x, y, z;
	for(x = 0; x < *goods_quantity; x++)			
	{
		for(y = x + 1; y < *goods_quantity; y++)
		{
			if(v_goods_list[x] == v_goods_list[y])
			{
				for(z = y; z < *goods_quantity - 1; z++)
				{
					v_goods_list[z] = v_goods_list[z+1];
				}
				(*goods_quantity)--;
				y--;	
			}
		}
				
	}
}
void V_Remove_First_Goods(list_station_t v_goods_list[4],  uint8_t goods_quantity)
{
	for(uint8_t x = 0;  x < goods_quantity; x++)
		v_goods_list[x] = v_goods_list[x+1];
}


void V_Cross_the_Intersection(void)
{
	switch(cross_interection_state)
	{
		case CHECK_SIGN_CROSS:
			{
				htim2.Instance -> CCR1 = 9868;
				htim2.Instance -> CCR2 = 9999;
				HAL_Delay(300);
				cross_interection_state = PASS_CROSS_1;
			}
			break;
		case PASS_CROSS_1:
			htim2.Instance -> CCR1 = 9868;
			htim2.Instance -> CCR2 = 9999;
			HAL_Delay(300);
			cross_interection_state = PASS_CROSS_2;
			break;
		case PASS_CROSS_2:
			htim2.Instance -> CCR1 = 9868;
			htim2.Instance -> CCR2 = 9999;
			HAL_Delay(300);
			if(process_state == COME_HOME)
			{
				if((agv_infor.agv_position == 1)  && (agv_infor.agv_side == 1))
				{
					state_come_home = LEFT_CH;
				}
			}
			else if(agv_infor.agv_position == goods_infor.goods_position[0])
			{
				if(process_state == SHIP)
				{
					ship_state = PUT_DOWN;
				}
				else 
					state_comeback = DONE_CB;
			}
			state_go = PROCESS_GO;
			cross_interection_state = CHECK_SIGN_CROSS;
			break;
	}
}

void V_Back_the_Intersection(void)
{
	switch(state_back_intersection)
	{
		case CHECK_SIGN_BACK:
			{
				htim2.Instance -> CCR1 = 9868;
				htim2.Instance -> CCR2 = 9999;
				HAL_Delay(300);
				state_back_intersection = PASS_BACK_1;
			}
			break;
		case PASS_BACK_1:
			htim2.Instance -> CCR1 = 9868;
			htim2.Instance -> CCR2 = 9999;
			HAL_Delay(300);
			state_back_intersection = TURN_LEFT_1;
			break;
		case TURN_LEFT_1:
			V_Turn_Left();
			state_back_intersection = TURN_LEFT_2;
			break;
		case TURN_LEFT_2:
			V_Turn_Left();
			state_back_intersection = PASS_BACK_2;
			break;
		case PASS_BACK_2:
			htim2.Instance -> CCR1 = 9868;
			htim2.Instance -> CCR2 = 9999;
			HAL_Delay(300);
			state_go = PROCESS_GO;
			state_back_intersection = CHECK_SIGN_BACK;
			break;
	}
}

void V_Turn_Left_at_the_Intersection(void)
{
	switch(turn_left_interection_state)
	{
		case CHECK_SIGN_LEFT:
			{
				htim2.Instance -> CCR1 = 9868;
				htim2.Instance -> CCR2 = 9999;
				HAL_Delay(300);
				turn_left_interection_state = PASS_LEFT_1;
			}
			break;
		case PASS_LEFT_1:
			htim2.Instance -> CCR1 = 9868;
			htim2.Instance -> CCR2 = 9999;
			HAL_Delay(300);
			turn_left_interection_state = TURN_LEFT;
			break;
		case TURN_LEFT:
			V_Turn_Left();
			turn_left_interection_state = PASS_LEFT_2;
			break;
		case PASS_LEFT_2:
			htim2.Instance -> CCR1 = 9868;
			htim2.Instance -> CCR2 = 9999;
			HAL_Delay(300);
			if(process_state == COME_HOME)
			{
				if((agv_infor.agv_position == 1)  && (agv_infor.agv_side == 1))
				{
					state_come_home = LEFT_CH;
				}
			}
			else if(agv_infor.agv_position == goods_infor.goods_position[0])
			{
				if((agv_infor.agv_direct == LEFT) && (agv_infor.agv_side == goods_infor.goods_side[0]))
				{
					if(process_state == SHIP)
						ship_state = PUT_DOWN;
					else 
						state_comeback = DONE_CB;
				}
				else if((agv_infor.agv_direct == RIGHT) && (agv_infor.agv_side == (goods_infor.goods_side[0]) + 1))
				{
					if(process_state == SHIP)
						ship_state = PUT_DOWN;
					else 
						state_comeback = DONE_CB;
				}
			}

			state_go = PROCESS_GO;
			turn_left_interection_state = CHECK_SIGN_LEFT;
			break;

	}
}

void V_Turn_Right_at_the_Intersection(void)
{
	switch(turn_right_interection_state)
	{
		case CHECK_SIGN_RIGHT:
			{
				htim2.Instance -> CCR1 = 9868;
				htim2.Instance -> CCR2 = 9999;
				HAL_Delay(300);
				turn_right_interection_state = TURN_RIGHT;
			}
			break;
		case TURN_RIGHT:
			V_Turn_Right();
			if(process_state == COME_HOME)
			{
				if((agv_infor.agv_position == 1)  && (agv_infor.agv_side == 1))
				{
					state_come_home = LEFT_CH;
				}
			}
			else if(agv_infor.agv_position == goods_infor.goods_position[0])
			{
				if((agv_infor.agv_direct == LEFT) && (agv_infor.agv_side == goods_infor.goods_side[0]))
				{
					if(process_state == SHIP)
						ship_state = PUT_DOWN;
					else 
						state_comeback = DONE_CB;
				}
				else if((agv_infor.agv_direct == RIGHT) && (agv_infor.agv_side == (goods_infor.goods_side[0]) + 1))
				{
					if(process_state == SHIP)
						ship_state = PUT_DOWN;
					else 
						state_comeback = DONE_CB;
				}
			}
			state_go = PROCESS_GO;
			turn_right_interection_state = CHECK_SIGN_RIGHT;
			break;
	}
}

void V_Put_Down(void)
{
	switch(state_put_down)
	{
		case PRE_DOWN:
			htim2.Instance -> CCR1 = 0;
			htim2.Instance -> CCR2 = 0;
			if(agv_infor.agv_direct == LEFT)
			{
				if(agv_infor.agv_side == 0)
				{
					if(agv_infor.agv_position == 2)
						Tx = '5';
					else 
						Tx = '6';
				}
				else
				{
					if(agv_infor.agv_position == 2)
						Tx = '7';
					else 
						Tx = '8';
				}
			}
			else
			{
				if(agv_infor.agv_side == 1)
				{
					if(agv_infor.agv_position == 2)
						Tx = '5';
					else 
						Tx = '6';
				}
				else
				{
					if(agv_infor.agv_position == 2)
						Tx = '7';
					else 
						Tx = '8';
				}
			}
			HAL_UART_Transmit(&huart1, &Tx, 1, 100);
			Lcd_Send_String_XY(1, 2, "PUTTING DOWN");
			state_put_down = WAIT_ROBOT;
			break;
		case WAIT_ROBOT:
			if(robot == reset)
				state_put_down = PROCESS_PUT_DOWN;
			break;
		case PROCESS_PUT_DOWN:
//			Lcd_Send_String_XY(1, 2, "DONE PUT DOWN");
//			systick_count = HAL_GetTick();
			robot = set;
			goods_infor.goods_quantity--;
			V_Remove_First_Goods(goods_infor.goods_list, goods_infor.goods_quantity);
			V_Analysis_Goods_List(goods_infor.goods_side, goods_infor.goods_position, goods_infor.goods_list);
			state_put_down = DONE_PUT_DOWN;
			break;
		case DONE_PUT_DOWN:
//			if((HAL_GetTick() -  systick_count) > 1500)
			{
				Lcd_Clear_Display();
				state_put_down = PRE_DOWN;
				ship_state = PROCESS_SHIP;
			}
			break;
	}
}
void V_Determine_Next_Step(void)
{
	switch(agv_infor.agv_direct)
	{
		case UP:
			if(goods_infor.goods_position[0] > (agv_infor.agv_position + 1))
			{
				agv_infor.agv_next_step_go = UP;
			}
			else
			{
				if(goods_infor.goods_side[0] < agv_infor.agv_side)
				{
					agv_infor.agv_next_step_go = RIGHT;
					agv_infor.agv_direct = RIGHT;
				}
				else
				{
					agv_infor.agv_direct = LEFT;
					agv_infor.agv_next_step_go = LEFT;
				}
			}
			agv_infor.agv_position++;
			break;
		case DOWN:
			if((goods_infor.goods_position[0] + 1)< agv_infor.agv_position)
			{
				if(process_state == COME_HOME)
				{
					if((goods_infor.goods_position[0] + 2) < agv_infor.agv_position)
						agv_infor.agv_next_step_go = UP;
					else if((goods_infor.goods_side[0] + 1) < agv_infor.agv_side)
					{
						agv_infor.agv_next_step_go = LEFT;
						agv_infor.agv_direct = RIGHT;
					}
					else if(goods_infor.goods_side[0] == agv_infor.agv_side)
					{
						agv_infor.agv_next_step_go = RIGHT;
						agv_infor.agv_direct = LEFT;
					}	
				}
				else
					agv_infor.agv_next_step_go = UP;
			}
			else
			{
				if(goods_infor.goods_side[0] < agv_infor.agv_side)
				{
					agv_infor.agv_next_step_go = LEFT;
					agv_infor.agv_direct = RIGHT;			
				}
				else
				{
					agv_infor.agv_direct = LEFT;
					agv_infor.agv_next_step_go = RIGHT;
				}
			}
			agv_infor.agv_position--;
			break;
		case LEFT:
			if(goods_infor.goods_position[0] == agv_infor.agv_position)
			{
				if(goods_infor.goods_side[0] > agv_infor.agv_side)
					agv_infor.agv_next_step_go = UP;
				else
				{
					agv_infor.agv_direct = RIGHT;
					agv_infor.agv_next_step_go = DOWN;
				}
			}
			else if(goods_infor.goods_position[0] < agv_infor.agv_position)
			{
				if((process_state == COME_HOME) && (goods_infor.goods_side[0] < agv_infor.agv_side) && ( agv_infor.agv_position == 1))
				{
					agv_infor.agv_next_step_go = DOWN;
					agv_infor.agv_direct = RIGHT;
				}
				else
				{
				agv_infor.agv_next_step_go = LEFT;
				agv_infor.agv_direct = DOWN;
				}
			}
			else
			{
				goods_infor.goods_tmp = 0;
				tmp_check = 0;
				for(uint8_t x = 1; x < goods_infor.goods_quantity; x++)
				{
					if(goods_infor.goods_side[0] != goods_infor.goods_side[x])
						goods_infor.goods_tmp = 1;
					else
						tmp_check = 1;
				}
				if(goods_infor.goods_side[0] > agv_infor.agv_side)
				{
					if(((goods_infor.goods_tmp == 1) && (tmp_check == 0)) || (goods_infor.goods_quantity == 1))
					{	
						agv_infor.agv_next_step_go = UP;
						tmp_check = 10;
					}
					else
					{
						agv_infor.agv_next_step_go = RIGHT;
						agv_infor.agv_direct = UP;
					}
				}
				else
				{
					agv_infor.agv_next_step_go = RIGHT;
					agv_infor.agv_direct = UP;
				}
			}
			agv_infor.agv_side++;
			break;
		case RIGHT:
			if(goods_infor.goods_position[0] == agv_infor.agv_position)
			{
				if(goods_infor.goods_side[0] < agv_infor.agv_side)
					agv_infor.agv_next_step_go = UP;
				else
				{
					agv_infor.agv_direct = LEFT;
					agv_infor.agv_next_step_go = DOWN;
				}
			}
			else if(goods_infor.goods_position[0] < agv_infor.agv_position)
			{
				if((process_state == COME_HOME) && ((goods_infor.goods_side[0] + 1) >= agv_infor.agv_side) && ( agv_infor.agv_position == 1))
				{
					agv_infor.agv_next_step_go = DOWN;
					agv_infor.agv_direct = LEFT;
				}
				else
				{
					agv_infor.agv_next_step_go = RIGHT;
					agv_infor.agv_direct = DOWN;
				}
			}
			else
			{
				goods_infor.goods_tmp = 0;
				tmp_check = 0;
				bool_t tmp_check_x = reset;
				for(uint8_t x = 1; x < goods_infor.goods_quantity; x++)
				{
					if(goods_infor.goods_side[0] > goods_infor.goods_side[x])
						goods_infor.goods_tmp = 1;
					else if(goods_infor.goods_side[0] < goods_infor.goods_side[x])
						tmp_check_x = set;
					else
						tmp_check = 1;
				}
				if(((goods_infor.goods_side[0] + 1) < agv_infor.agv_side) || (tmp_check_x == set))
				{
					agv_infor.agv_next_step_go = LEFT;
					agv_infor.agv_direct = UP;
				}
				else if(((goods_infor.goods_tmp == 1) && (tmp_check == 0)) || ((goods_infor.goods_quantity == 1) && ((agv_infor.agv_side == 2) || (agv_infor.agv_side == goods_infor.goods_side[0]))))
				{	
					agv_infor.agv_next_step_go = DOWN;
					agv_infor.agv_direct = LEFT;
				}
				else
				{
					agv_infor.agv_next_step_go = LEFT;
					agv_infor.agv_direct = UP;
				}
			}
			agv_infor.agv_side--;
			break;
		default:
			break;
	}
}
void V_GO(void)
{
	switch(state_go)
	{
		case PROCESS_GO:
		{	
			V_Determine_Next_Step();
			state_go = WAIT_CROSS;
			break;
		}
		case WAIT_CROSS:
		{
			state_moving = MOVE;
			switch(agv_infor.agv_next_step_go)
			{
				case UP:
					V_Cross_the_Intersection();
					break;
				case DOWN:
					V_Back_the_Intersection();
					break;
				case LEFT:
					V_Turn_Left_at_the_Intersection();
					break;
				case RIGHT:
					V_Turn_Right_at_the_Intersection();
					break;
				default:
					break;
			}
			break;
		}
	}
}
void V_Ship(void)
{
	uint16_t distance_min;
	list_station_t tmp;
	uint8_t tmp_rs_2, tmp_rs_3, tmp_rs_4;
	bool_t check_rs1 = reset, check_rs2 = reset, check_rs3 = reset, check_rs4 = reset;
	switch (ship_state)
	{
		case PROCESS_SHIP:
		{	
			if(goods_infor.goods_quantity == 0)
				ship_state = DONE_SHIP;
			else 
			{
				if(goods_infor.goods_quantity > 1)
				{
					distance_min = 255;
					for(uint8_t x = 0; x < goods_infor.goods_quantity; x++)
					{
						if(agv_infor.agv_position == 1)
						{
							switch(goods_infor.goods_list[x])
							{
								case RS1:
									check_rs1 = set;
									break;
								case RS2:
									tmp_rs_2 = x;
									check_rs2 = set;
									break;
								case RS3:
									tmp_rs_3 = x;
									check_rs3 = set;
									break;
								case RS4:
									tmp_rs_4 = x;
									check_rs4 = set;
									break;
								default:
									break;
							}
						}
						distance_tmp = V_Determine_Distance(agv_infor.agv_side, agv_infor.agv_position, goods_infor.goods_side[x], goods_infor.goods_position[x], agv_infor.agv_direct);
						if(distance_tmp < distance_min)
						{
								goods_infor.goods_tmp = x;
								distance_min = distance_tmp;
						}
					}
					if(agv_infor.agv_position == 1)
					{
						if(agv_infor.agv_direct == LEFT)
						{
							if(agv_infor.agv_side == 0)
							{
								if(goods_infor.goods_quantity == 3)
								{
									if(check_rs4 == reset)
										goods_infor.goods_tmp = tmp_rs_2;
								}
								else if(goods_infor.goods_quantity == 2)
								{
									if((check_rs1 == set) && (check_rs2 == set))
										goods_infor.goods_tmp = tmp_rs_2;
								}
							}
							else if(agv_infor.agv_side == 1)
							{
								if(goods_infor.goods_quantity == 4)
									goods_infor.goods_tmp = tmp_rs_4;
								else if(goods_infor.goods_quantity == 3)
								{
									if(check_rs4 == set)
										goods_infor.goods_tmp = tmp_rs_4;
								}
								else if(goods_infor.goods_quantity == 2)
								{
									if((check_rs3 == set) && (check_rs4 == set))
										goods_infor.goods_tmp = tmp_rs_4;
									else if((check_rs1 == set) && (check_rs2 == set))
										goods_infor.goods_tmp = tmp_rs_2;
								}
							}
						}	
						else if(agv_infor.agv_direct == RIGHT)
						{
							if(agv_infor.agv_side == 2)
							{
								if(goods_infor.goods_quantity == 2)
								{
									if((check_rs1 == set) && (check_rs2 == set))
										goods_infor.goods_tmp = tmp_rs_2;
								}
							}
							else if(agv_infor.agv_side == 1)
							{
								if(goods_infor.goods_quantity == 3)
								{
									if(check_rs1 == reset)
										goods_infor.goods_tmp = tmp_rs_3;
								}
							}
						}
					}
					tmp = goods_infor.goods_list[0]; 
					goods_infor.goods_list[0] = goods_infor.goods_list[goods_infor.goods_tmp];
					goods_infor.goods_list[goods_infor.goods_tmp] = tmp;
					V_Analysis_Goods_List(goods_infor.goods_side, goods_infor.goods_position, goods_infor.goods_list);
					
				}
				switch(goods_infor.goods_list[0])
				{
					case RS1:
						Lcd_Send_String_XY(1, 3, "GOING TO RS1");
						Tx = 'K';
						break;
					case RS2:
						Lcd_Send_String_XY(1, 3, "GOING TO RS2");
						Tx = 'L';
						break;
					case RS3:
						Lcd_Send_String_XY(1, 3, "GOING TO RS3");
						Tx = 'M';
						break;
					case RS4:
						Lcd_Send_String_XY(1, 3, "GOING TO RS4");
						Tx = 'N';
						break;
					default:
						break;
				}
				HAL_UART_Transmit(&huart1, &Tx, 1, 100);
				Tx = 'D';
				HAL_UART_Transmit(&huart1, &Tx, 1, 100);
				ship_state = GO_SHIP;
			}
			break;
		}
		case GO_SHIP:
		{
			V_GO();
			break;
		}
		case PUT_DOWN:
			V_Put_Down();
			break;
		case DONE_SHIP:
			if(((goods_infor.goods_station[0] == reset) && (goods_infor.goods_station[1] == reset)) || (agv_infor.agv_power == reset))
			{
				process_state = COME_HOME;
				goods_infor.goods_list[0] = PS1;
			}
			else
			{
				process_state = COME_BACK;
				if((goods_infor.goods_station[0] == set) && (goods_infor.goods_station[1] == set))
				{
					if(((agv_infor.agv_direct == RIGHT) && (agv_infor.agv_side == 1)))
						goods_infor.goods_list[0] = TS1;
					else
						goods_infor.goods_list[0] = TS2;
				}
				else if(goods_infor.goods_station[0] == set)
					goods_infor.goods_list[0] = TS1;
				else
					goods_infor.goods_list[0] = TS2;
			}
			goods_infor.goods_quantity = 0;
			ship_state = PROCESS_SHIP;
			break;
	 }
}

void V_Come_Back(void)
{
	switch(state_comeback)
	{
		case PRE_CB:
			goods_infor.goods_position[0] = goods_infor.goods_list[0] & 3;
			goods_infor.goods_side[0] = (bool_t)((goods_infor.goods_list[0] & 4) >> 2);
			switch(goods_infor.goods_list[0])
			{
				case TS1:
					Lcd_Send_String_XY(1, 3, "GOING TO TS1");
					Tx = 'H';
					break;
				case TS2:
					Lcd_Send_String_XY(1, 3, "GOING TO TS2");
					Tx = 'I';
					break;
				default:
					break;
			}
			HAL_UART_Transmit(&huart1, &Tx, 1, 100);
			Tx = '9';
			HAL_UART_Transmit(&huart1, &Tx, 1, 100);
			state_comeback = GO_CB;
			break;
		case GO_CB:
			V_GO();
			break;
		case DONE_CB:
			process_state = PICK_UP;
			state_comeback = PRE_CB;
			break;
	}
}
void V_Come_Home(void)
{
	switch(state_come_home)
	{
		case PRE_CH:
			goods_infor.goods_position[0] = goods_infor.goods_list[0] & 3;
			goods_infor.goods_side[0] = (bool_t)((goods_infor.goods_list[0] & 4) >> 2);
			Lcd_Send_String_XY(1, 4, "GOING TO");
			Lcd_Goto_XY(2, 2);
			Lcd_Send_String("THE PARKING");
			Tx = 'G';
			HAL_UART_Transmit(&huart1, &Tx, 1, 100);
			Tx = 'A';
			HAL_UART_Transmit(&huart1, &Tx, 1, 100);
			state_come_home = GO_HOME;
			break;
		case GO_HOME:
			V_GO();
			break;
		case LEFT_CH:
			state_moving = MOVE;
			state_come_home = WAIT_DONE_CH;
			htim2.Instance -> CCR1 = 9868;
			htim2.Instance -> CCR2 = 9999;
			HAL_Delay(300);
			break;
		case WAIT_DONE_CH:
			V_Turn_Left();
			state_moving = MOVE;
			state_come_home = DONE_CH;	
			break;
		case DONE_CH:
			htim2.Instance -> CCR1 = 9868;
			htim2.Instance -> CCR2 = 9999;
			HAL_Delay(1000);
			GPIO_RESET_PIN(GPIOA, GPIO_PIN_10);	//STB`
			HAL_TIM_PWM_Stop(&htim2, TIM_CHANNEL_1);
			HAL_TIM_PWM_Stop(&htim2, TIM_CHANNEL_2);
			break;
	}
}



/* USER CODE END 4 */
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
