vanson2209/final_project/Code/AGV/AGV.ioc

Mcu.UserName=STM32F103C8Tx
PA0-WKUP.Signal=ADCx_IN0
PA1.Signal=ADCx_IN1
PA10.Signal=GPIO_Output
PA11.Signal=GPIO_Output
PA12.Signal=GPIO_Output
PA13.Signal=SYS_JTMS-SWDIO
PA14.Signal=SYS_JTCK-SWCLK
PA15.Signal=S_TIM2_CH1_ETR
PA2.Signal=ADCx_IN2
PA3.Signal=ADCx_IN3
PA4.Signal=ADCx_IN4
PA5.Signal=GPIO_Input
PA6.Signal=GPIO_Input
PA7.Signal=GPXTI7
PB0.Signal=GPIO_Input
PB1.Signal=GPIO_Input
PB10.Signal=I2C2_SCL
PB11.Signal=I2C2_SDA
PB12.Signal=GPIO_Output
PB13.Signal=GPIO_Output
PB14.Signal=GPIO_Input
PB15.Signal=GPIO_Input
PB2.Signal=GPXTI2
PB3.Signal=S_TIM2_CH2
PB4.Signal=GPIO_Output
PB5.Signal=GPIO_Output
PB6.Signal=USART1_TX
PB7.Signal=USART1_RX
PB8.Signal=GPIO_Input
PB9.Signal=GPIO_Input
