vanson2209/final_project/Code/AGV/Core/Inc/flash.h

#ifndef __flash_h
#define __flash_h
#include <stdint.h>
#include <string.h>

#pragma pack(1)
typedef struct{
	uint8_t no;
	uint8_t ssid[30];
	uint8_t pass[30];
} wifi_info_t;
#pragma pack()

void Flash_Erase (uint32_t address);
void Flash_Write_Int(uint32_t address, int value);
void Flash_Write_Float(uint32_t address, float f);
void Flash_Write_Array(uint32_t address, uint8_t *arr, uint16_t len);
void Flash_Write_Struct(uint32_t address, wifi_info_t dta);

int Flash_Read_Int(uint32_t address);
float Flash_Read_Float(uint32_t address);
void Flash_Read_Array(uint32_t address, uint8_t *arr, uint16_t len);
void Flash_Read_Struct(uint32_t address, wifi_info_t *dta);
#endif
