vanson2209/final_project/(notices)

Notices in the files:
Code/AGV/Core/Src/main.c:
Copyright (c) 2024 STMicroelectronics.
All rights reserved.
This software is licensed under terms that can be found in the LICENSE file
